Person-0/MiniQuad0/README.md

# **MiniQuad0**
Tiny Brushless Quadcopter, smaller and simpler version of Quad0.<br>
Custom flight controller with self-assembly in mind.

## 😼💖
