Person-0/MiniQuad0/bom.csv

 |  |  |  |  | INR | INR
S.No | Name | Desc | Product URL | Qty | Unit Cost | Effective Cost | Notes
1 | 100nf Capacitors | 0603 | https://robu.in/product/cc0603jpx7r9bb104-yageo-cap-ceramic-0-1uf-50v-x7r-5-pad-smd-0603-125c-t-r/ | 10 | 1.2 | 12 | INR Effective cost required to be >10inr by robu.in
2 | 1k Resistors | 1206 | https://robu.in/product/rc1206fr-071kl-yageo-res-thick-film-1206-1k-ohm-1-0-25w1-4w-%c2%b1100ppm-c-pad-smd-t-r/ | 21 | 0.49 | 10.29 | INR Effective cost required to be >10inr by robu.in
3 | 10k Resistors | 1206 | https://robu.in/product/rc1206fr-0710kl-yageo-res-thick-film-1206-10k-ohm-1-0-25w1-4w-%c2%b1100ppm-c-pad-smd-t-r/ | 20 | 0.52 | 10.4 | INR Effective cost required to be >10inr by robu.in
4 | 3.3k Resistors | 1206 | https://robu.in/product/rc1206fr-073k3l-yageo-res-thick-film-1206-3-3k-ohm-1-0-25w1-4w-%c2%b1100ppm-c-pad-smd-t-r/ | 20 | 0.53 | 10.6 | INR Effective cost required to be >10inr by robu.in
5 | 4.7k Resistors | 1206 | https://robu.in/product/rc1206fr-074k7l-yageo-res-thick-film-1206-4-7k-ohm-1-0-25w1-4w-%c2%b1100ppm-c-pad-smd-t-r/ | 22 | 0.47 | 10.34 | INR Effective cost required to be >10inr by robu.in
6 | LSM6DSOTR | LGA-14 | https://robu.in/product/stmicroelectronics-lsm6dso-6-axis-imu-sensor-c2b116g/ | 1 | 369 | 369
7 | XIAO RP2350 | mcu | https://robu.in/product/seeedstudio-xiao-rp2350-raspberry-pi-rp2350/ | 1 | 829 | 829
8 | HMC5883L breakout | breakout board | https://quartzcomponents.com/products/hmc5883l-triple-axis-magnetometer-board | 1 | 278 | 278
9 | BMP280 breakout | breakout board to obtain the IC | https://quartzcomponents.com/products/bmp280-pressure-sensor-module | 1 | 33 | 33
10 | PDB-XT60 w BEC | power distribution board with bec | https://quartzcomponents.com/products/pdb-xt60-5v-12v-power-distribution-board-with-bec | 1 | 389 | 389
11 | XT60 Connector wire | xt60 male connector wire | https://quartzcomponents.com/products/xt60-male-connector-with-14awg-silicone-wire | 1 | 62 | 62
12 | Cyclone BLHeli_S 35A ESC | 35a esc w blheli_s support | https://evelta.com/cyclone-blheli_s-35a-45a-esc-2-5s-2-6s-lipo/ | 4 | 960 | 3840
13 | MT2204 2300KV CW | bldc 2300kv motor cw | https://evelta.com/mt2204-2300kv-cw-brushless-motor-black-cap/ | 2 | 520 | 1040
14 | MT2204 2300KV CCW | bldc 2300kv motor ccw | https://evelta.com/mt2204-2300kv-ccw-brushless-motor/ | 2 | 520 | 1040
15 | PCB Fab Cost | PCB Fab Cost | https://www.lioncircuits.com/ | 1 | 0 | 0
16 | 3S 1300mAh LiPo | lipo battery | https://robu.in/product/orange-1300mah-3s-40c-11-1-v-lithium-polymer-battery-pack-lipo/ | 1 | 1629 | 1629
17 | EasyMech Set of M4x10mm Socket Head Cap (Allen) Bolt and Nut (12Pcs) | scew bolt combo | https://robu.in/product/easymech-set-of-m4-x-8mm-socket-head-cap-allen-bolt-and-nut-12-pcs/ | 1 | 113 | 113
18 | EasyMech M4x16mm HT Socket Button Head Cap Allen Bolt (25Pcs) | scew bolt combo | https://robu.in/product/easymech-ht-socket-button-head-cap-allen-bolt-m4-x-16-25-pcs/ | 1 | 181 | 181
19 | Nylon zip ties | zip ties, pack of 100 | https://robu.in/product/nylon-cable-zip-ties-100mm-100pcs-bag-1-bag/ | 1 | 30 | 30
 |  |  |  |  | Total (INR): | 9886.63
 |  |  |  |  | Total (USD): | 108.75293
 |  |  |  |  | (1INR=0.011 USD)
