Person-0/MiniQuad0/CAD/exports/pcb_board.step

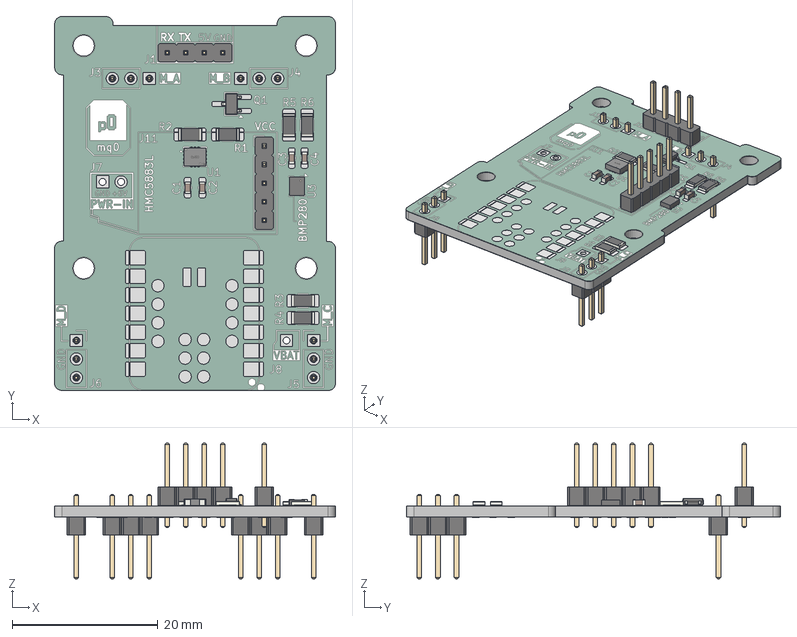
[picture p1: CAD file, 2026-11-10]
CAD/exports/pcb_board.step
38.5 x 51.2 x 18.6 mm
R_1206_3216Metric x 6
LGA-14_L2.5-W3.0-H0.9-P0.50
C_0603_1608Metric x 4
PinHeader_1x04_P2.54mm_Vertical
PinHeader_1x03_P2.54mm_Vertical x 4
Bosch_LGA-8_2x2.5mm_P0.65mm_ClockwisePinNumbering
TSOT-23
PinHeader_1x05_P2.54mm_Vertical
MiniQuad0_pad
MiniQuad0_silkscreen x 2
MiniQuad0_soldermask x 2
MiniQuad0_PCB
