Person-0/MiniQuad0/CAD/exports/TestMotorMountFrame.step

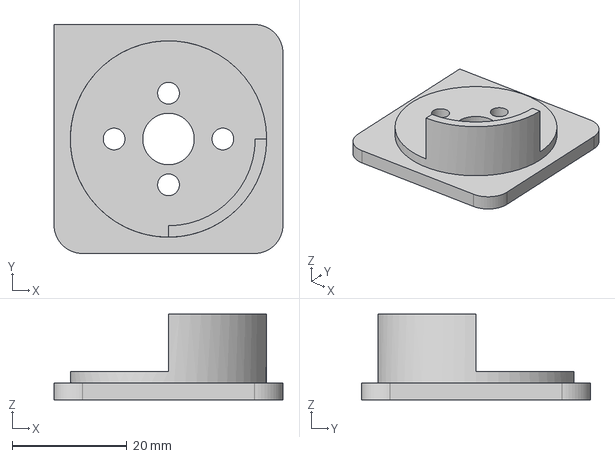
[picture p2: CAD file, 2026-11-10]
CAD/exports/TestMotorMountFrame.step
40.0 x 40.0 x 15.0 mm
