Person-0/MiniQuad0/PCB/MiniQuad0/MiniQuad0.kicad_pcb

## KiCad design PCB/MiniQuad0/MiniQuad0.kicad_pcb (2026-11-10)

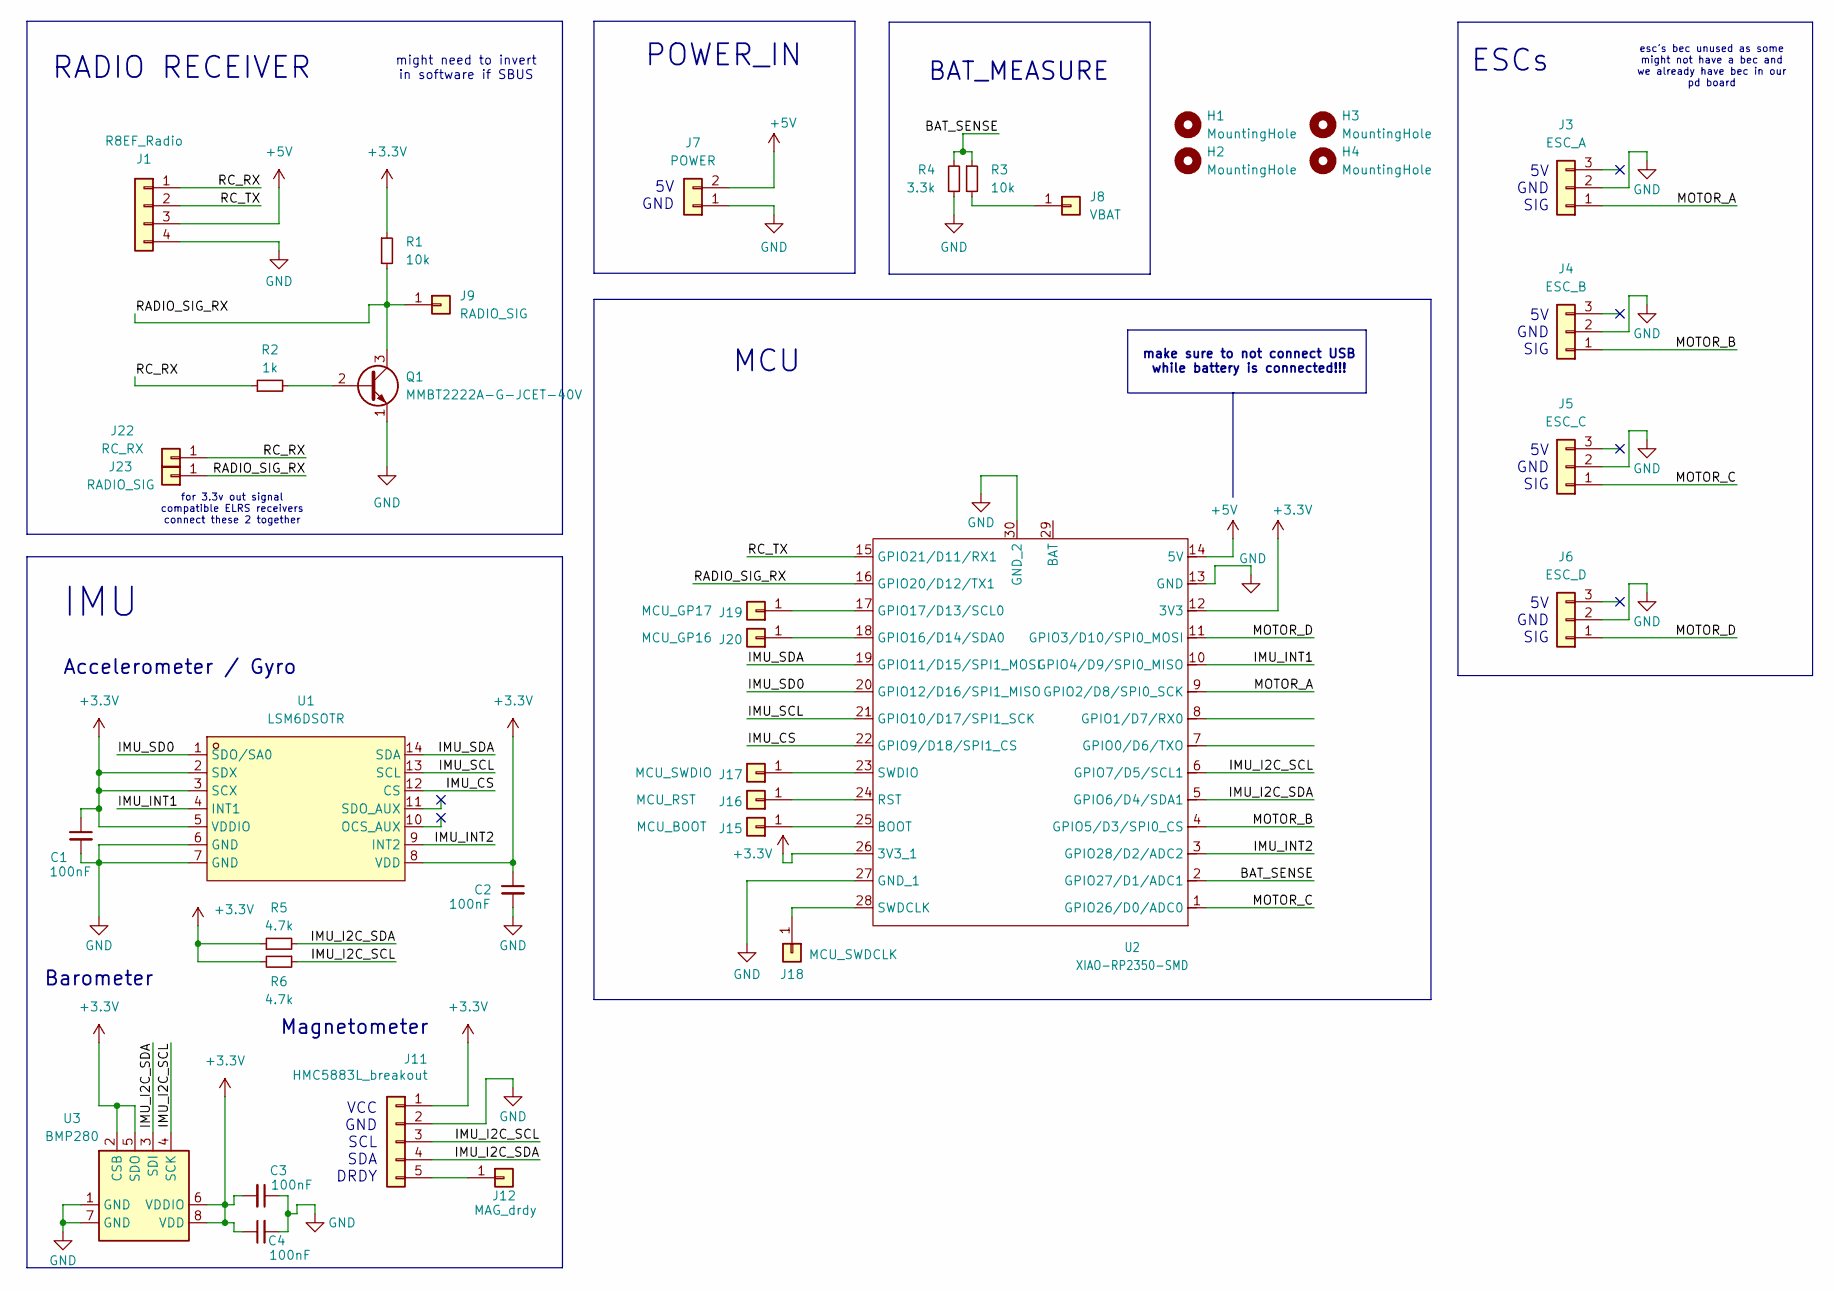
[picture p3: schematic MiniQuad0.kicad_sch]

Parts:
C1, C2, C3, C4: 100nF; C_0603_1608Metric_Pad1.08x0.95mm_HandSolder
H1, H2, H3, H4: MountingHole; MountingHole_3mm
J1: R8EF_Radio; PinHeader_1x04_P2.54mm_Vertical
J3: ESC_A; PinHeader_1x03_P2.54mm_Vertical
J4: ESC_B; PinHeader_1x03_P2.54mm_Vertical
J5: ESC_C; PinHeader_1x03_P2.54mm_Vertical
J6: ESC_D; PinHeader_1x03_P2.54mm_Vertical
J7: POWER; PinHeader_1x02_P2.54mm_Vertical
J8: VBAT; PinHeader_1x01_P2.54mm_Vertical
J9, J23: RADIO_SIG; TestPoint_Pad_D1.0mm
J11: HMC5883L_breakout; PinHeader_1x05_P2.54mm_Vertical
J12: MAG_drdy; TestPoint_Pad_D1.0mm
J15: MCU_BOOT; TestPoint_Pad_D1.0mm
J16: MCU_RST; TestPoint_Pad_D1.0mm
J17: MCU_SWDIO; TestPoint_Pad_D1.0mm
J18: MCU_SWDCLK; TestPoint_Pad_D1.0mm
J19: MCU_GP17; TestPoint_Pad_D1.0mm
J20: MCU_GP16; TestPoint_Pad_D1.0mm
J22: RC_RX; TestPoint_Pad_D1.0mm
Q1: MMBT2222A-G-JCET-40V; TSOT-23_HandSoldering
R1, R3: 10k; R_1206_3216Metric_Pad1.30x1.75mm_HandSolder
R2: 1k; R_1206_3216Metric_Pad1.30x1.75mm_HandSolder
R4: 3.3k; R_1206_3216Metric_Pad1.30x1.75mm_HandSolder
R5, R6: 4.7k; R_1206_3216Metric_Pad1.30x1.75mm_HandSolder
U1: LSM6DSOTR; LGA-14_L3.0-W2.5-P0.50-TL; MPN LSM6DSOTR; LCSC Part C2655100
U2: XIAO-RP2350-SMD
U3: BMP280; Bosch_LGA-8_2x2.5mm_P0.65mm_ClockwisePinNumbering

Connections:
+3.3V: C1.1, C2.1, C3.2, C4.1, J11.1, R1.1, R5.1, R6.2, U1.2 (SDX), U1.3 (SCX), U1.5 (VDDIO), U1.8 (VDD), U2.12 (3V3), U2.26 (3V3_1), U3.2 (CSB), U3.5 (SDO), U3.6 (VDDIO), U3.8 (VDD)
+5V: J1.3, J7.2, U2.14 (5V)
/BAT_SENSE: R3.1, R4.2, U2.2 (GPIO27/D1/ADC1)
/IMU_CS: U1.12 (CS), U2.22 (GPIO9/D18/SPI1_CS)
/IMU_I2C_SCL: J11.3, R6.1, U2.6 (GPIO7/D5/SCL1), U3.4 (SCK)
/IMU_I2C_SDA: J11.4, R5.2, U2.5 (GPIO6/D4/SDA1), U3.3 (SDI)
/IMU_INT1: U1.4 (INT1), U2.10 (GPIO4/D9/SPI0_MISO)
/IMU_INT2: U1.9 (INT2), U2.3 (GPIO28/D2/ADC2)
/IMU_SCL: U1.13 (SCL), U2.21 (GPIO10/D17/SPI1_SCK)
/IMU_SD0: U1.1 (SDO/SA0), U2.20 (GPIO12/D16/SPI1_MISO)
/IMU_SDA: U1.14 (SDA), U2.19 (GPIO11/D15/SPI1_MOSI)
/MOTOR_A: J3.1, U2.9 (GPIO2/D8/SPI0_SCK)
/MOTOR_B: J4.1, U2.4 (GPIO5/D3/SPI0_CS)
/MOTOR_C: J5.1, U2.1 (GPIO26/D0/ADC0)
/MOTOR_D: J6.1, U2.11 (GPIO3/D10/SPI0_MOSI)
/RADIO_SIG_RX: J9.1, J23.1, Q1.3 (C), R1.2, U2.16 (GPIO20/D12/TX1)
/RC_RX: J1.1, J22.1, R2.1
/RC_TX: J1.2, U2.15 (GPIO21/D11/RX1)
GND: C1.2, C2.2, C3.1, C4.2, J1.4, J3.2, J4.2, J5.2, J6.2, J7.1, J11.2, Q1.1 (E), R4.1, U1.6 (GND), U1.7 (GND), U2.13 (GND), U2.27 (GND_1), U2.30 (GND_2), U3.1 (GND), U3.7 (GND)
unnamed: J8.1, R3.2
unnamed: J11.5, J12.1
unnamed: J15.1, U2.25 (BOOT)
unnamed: J16.1, U2.24 (RST)
unnamed: J17.1, U2.23 (SWDIO)
unnamed: J18.1, U2.28 (SWDCLK)
unnamed: J19.1, U2.17 (GPIO17/D13/SCL0)
unnamed: J20.1, U2.18 (GPIO16/D14/SDA0)
unnamed: Q1.2 (B), R2.2

Notes on the sheet:
Accelerometer / Gyro
esc's bec unused as some might not have a bec and we already have bec in our pd board
IMU
Barometer
RADIO RECEIVER
make sure to not connect USB while battery is connected!!!
5V GND SIG
BAT_MEASURE
Magnetometer
POWER_IN
ESCs
MCU
for 3.3v out signal compatible ELRS receivers connect these 2 together
VCC GND SCL SDA DRDY
might need to invert in software if SBUS
5V GND

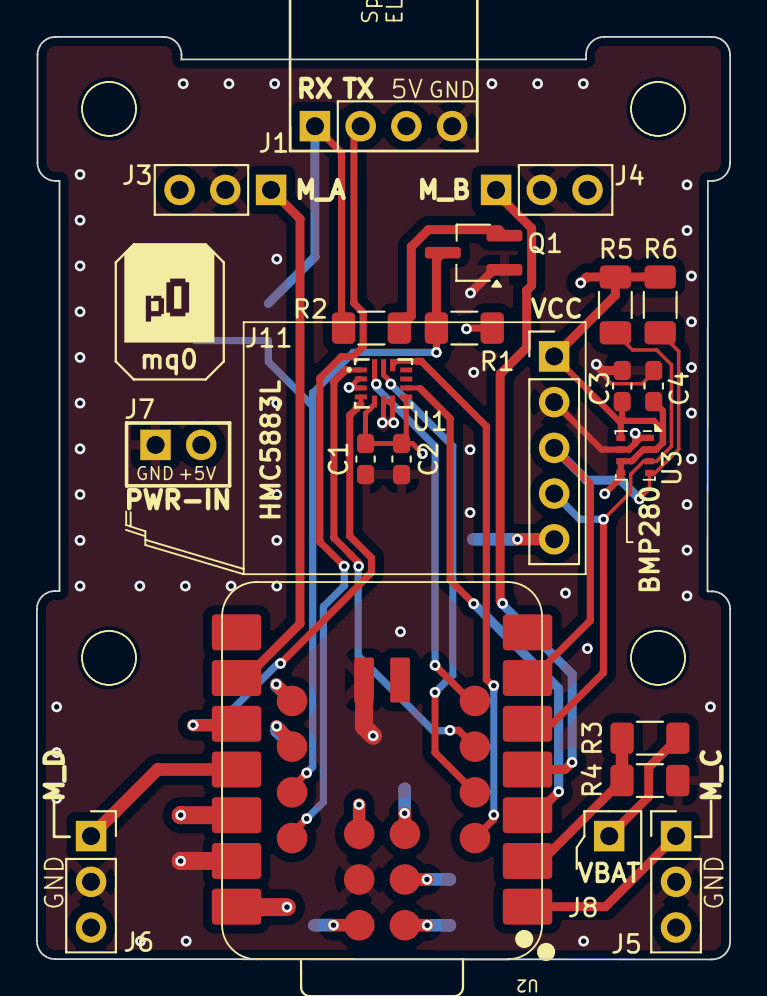
[picture p4: board MiniQuad0.kicad_pcb from above]

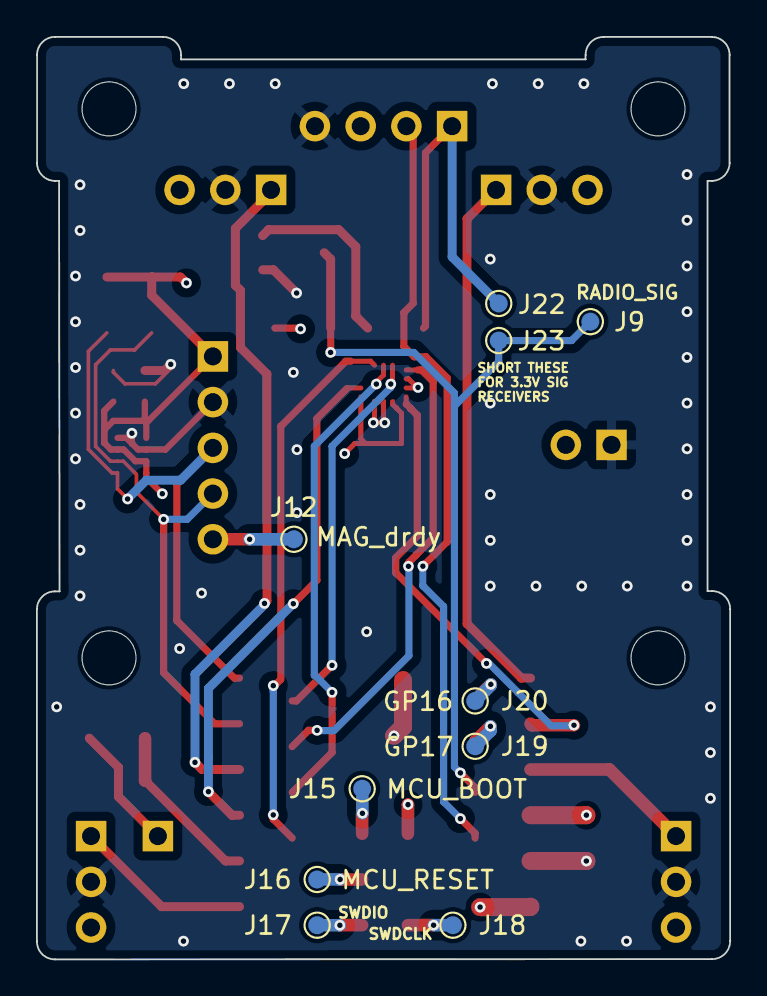
[picture p5: board MiniQuad0.kicad_pcb from below]

Board: 4 copper layers, 38.5 x 51.2 mm, 36 parts (10 on the bottom side), 28 nets.
