Person-0/MiniQuad0/(commit log)

2026-10-27 schematics finish r1
    [MiniQuad0.kicad_pcb, MiniQuad0.kicad_sch]
2026-10-29 remove obsolete pcb data
    [MiniQuad0.kicad_pcb]
2026-10-30 schematics update, pcb layout r2
    [MiniQuad0.kicad_pcb, MiniQuad0.kicad_sch]
2026-10-30 changed pin defs, finished PCB
    [MiniQuad0.kicad_pcb, MiniQuad0.kicad_sch]
2026-10-30 added test pads for unused pins under the mcu which were inaccessible otherwise
    [MiniQuad0.kicad_pcb, MiniQuad0.kicad_sch]
2026-10-30 hide vbat header model since it would be a directly soldered wire
    [MiniQuad0.kicad_pcb]
2026-10-30 exported pcb 3d model
    [MiniQuad0.kicad_pcb, pcb_board.step]
2026-11-03 pcb real finish. used bmp280 ic footprint, elrs receiver pinheader footprint and silkscreen art.
    [MiniQuad0.kicad_pcb, MiniQuad0.kicad_sch, pcb_board.step]
2026-11-10 updates idk
    [MiniQuad0.kicad_pcb, MiniQuad0.kicad_sch, TestMotorMountFrame.step, bom.csv, pcb_board.step]
2026-11-12 added zip ties to bom
    [bom.csv]
2026-11-12 imu tests (working)
2026-11-12 change board name and manfid :p
